zhangwenjun123456789/jsq/README.md

# BeanCounter
[][cc-by-sa]

A Simple, Affordable, Counter for Cut Tape and Partial Reels.

Now in Pre-Launch on [CrowdSupply](https://www.crowdsupply.com/great-big-factory/beancounter)!

pcb文件用立创eda pro版打开

[cc-by-sa]: http://creativecommons.org/licenses/by-sa/4.0/
[cc-by-sa-shield]: https://img.shields.io/badge/License-CC%20BY--SA%204.0-lightgrey.svg
