zhangwenjun123456789/jsq/hardware/3d打印支架/beancount v3.stl

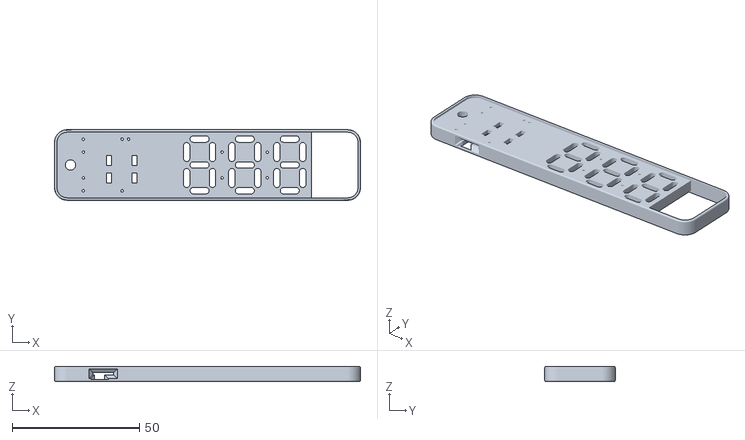
[picture p1: CAD file, 2022-06-13]
hardware/3d打印支架/beancount v3.stl
120.4 x 27.8 x 5.90
