zhangwenjun123456789/jsq/(list of files, cad)

Other CAD files:
hardware/3d打印支架/beancount v3.f3d
