zhangwenjun123456789/jsq/hardware/主板pcb/Schematic_beancounter.pdf

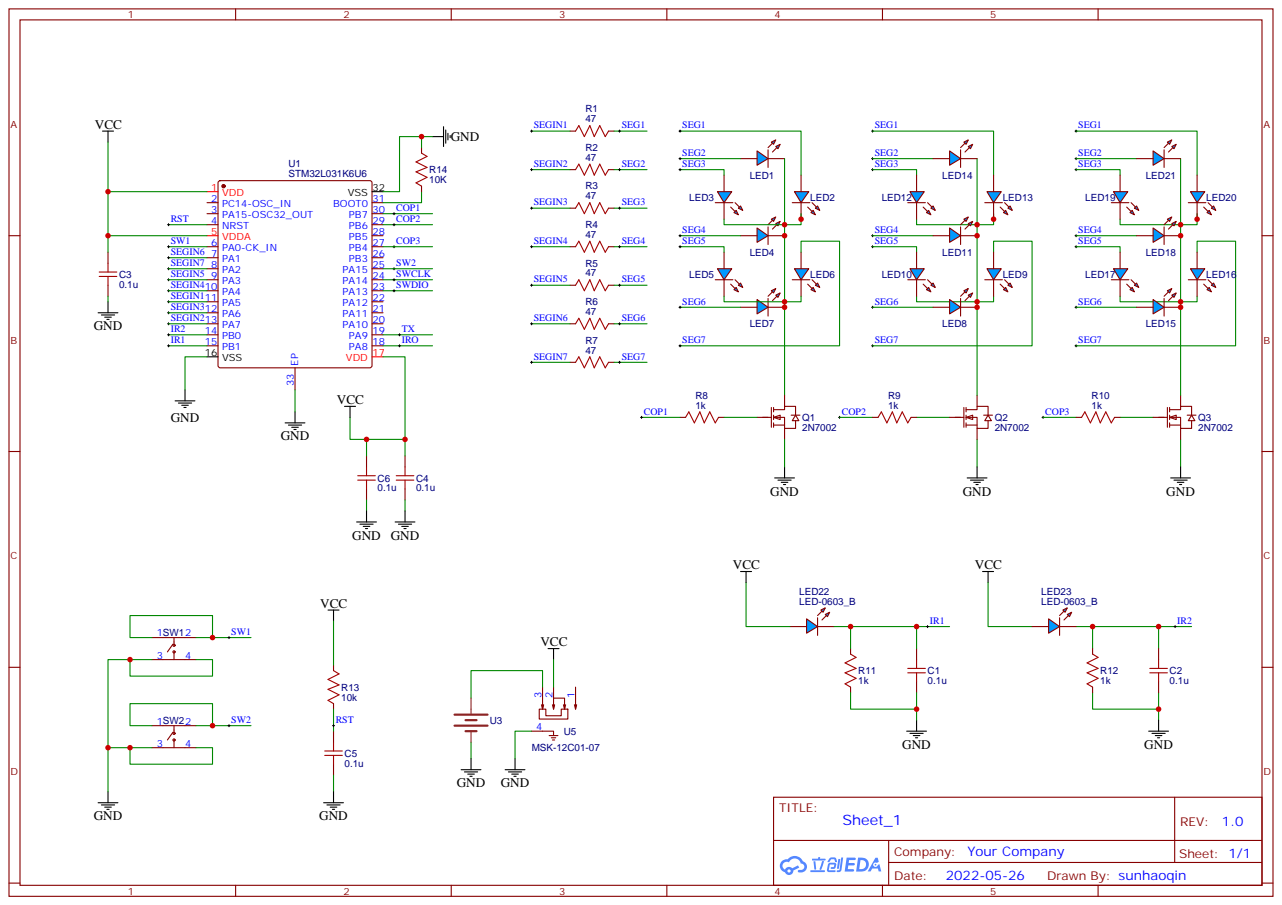
[picture p2: page 1]
