zhangwenjun123456789/jsq/(list of files, drawings)

Other design files:
hardware/主板pcb/SCH_beancounter.json
