zhangwenjun123456789/jsq/hardware/面板pcb/topboardcombined.brd

## EAGLE design hardware/面板pcb/topboardcombined.brd (2022-06-13)

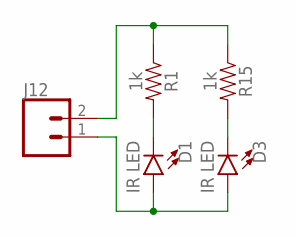
[picture p3: schematic topboardcombined.sch]

Parts:
D1, D3: IR LED; LED-0603
J12: CONN_02; 1X02
R1, R15: 1k; 0603

Connections:
unnamed: J12.2, R1.1, R15.1
unnamed: D1.C, R1.2
unnamed: D3.C, R15.2
unnamed: D1.A, D3.A, J12.1

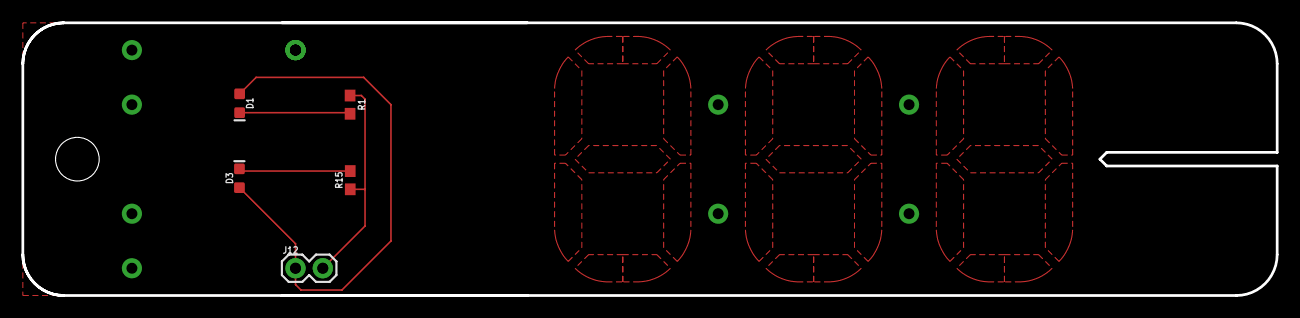
[picture p4: board topboardcombined.brd from above]

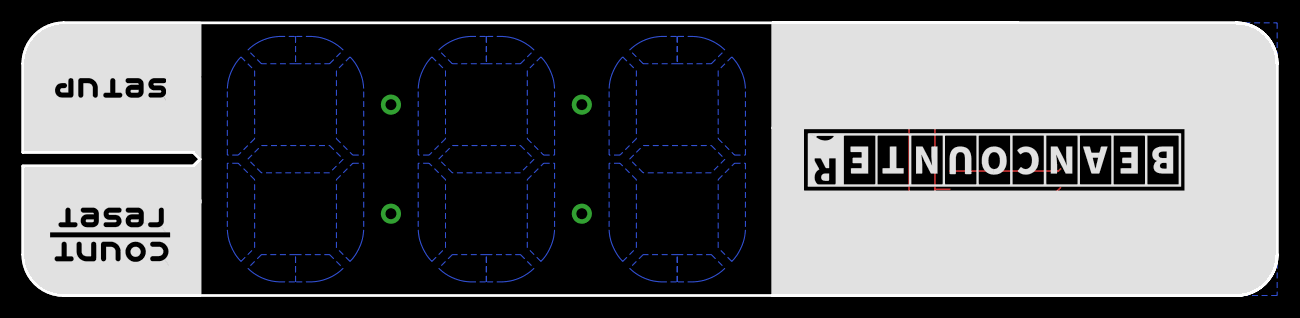
[picture p5: board topboardcombined.brd from below]

Board: 2 copper layers, 116.8 x 25.4 mm, 9 parts (4 on the bottom side), 4 nets.

Other parts of the board:
U$1: #COUNT#0
U$2: #RESET#0
U$3: #SETUP#0
U$4: LOGO#SVG0
