zhangwenjun123456789/jsq/(notices)

Notices in the files:
README.md:
CC BY-SA 4.0
parts and their libraries:
SparkFun-LED: Licensing: Creative Commons ShareAlike 4.0 International - https://creativecommons.org/licenses/by-sa/4.0
